NOTIFYII/notifyi-digital-twin/assets/research/capstone_poster.jpg

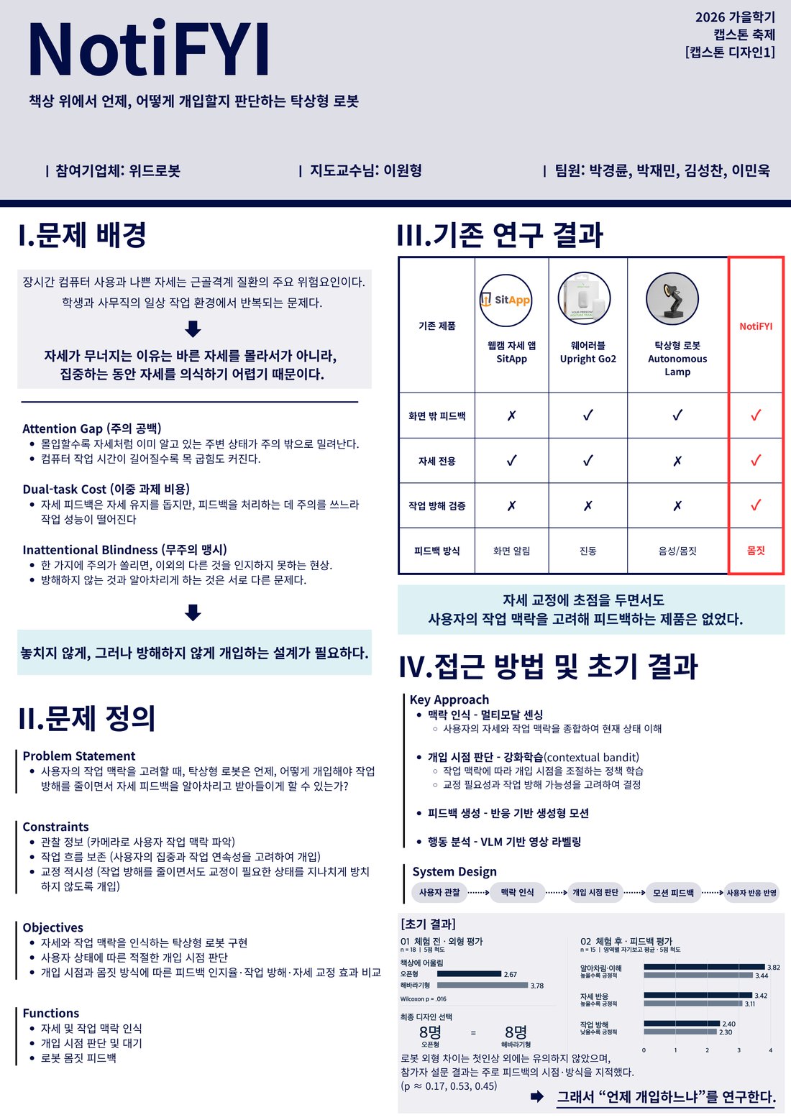
assets/research/capstone_poster.jpg
