NOTIFYII/notifyi-digital-twin/assets/research/botanical_device.jpg

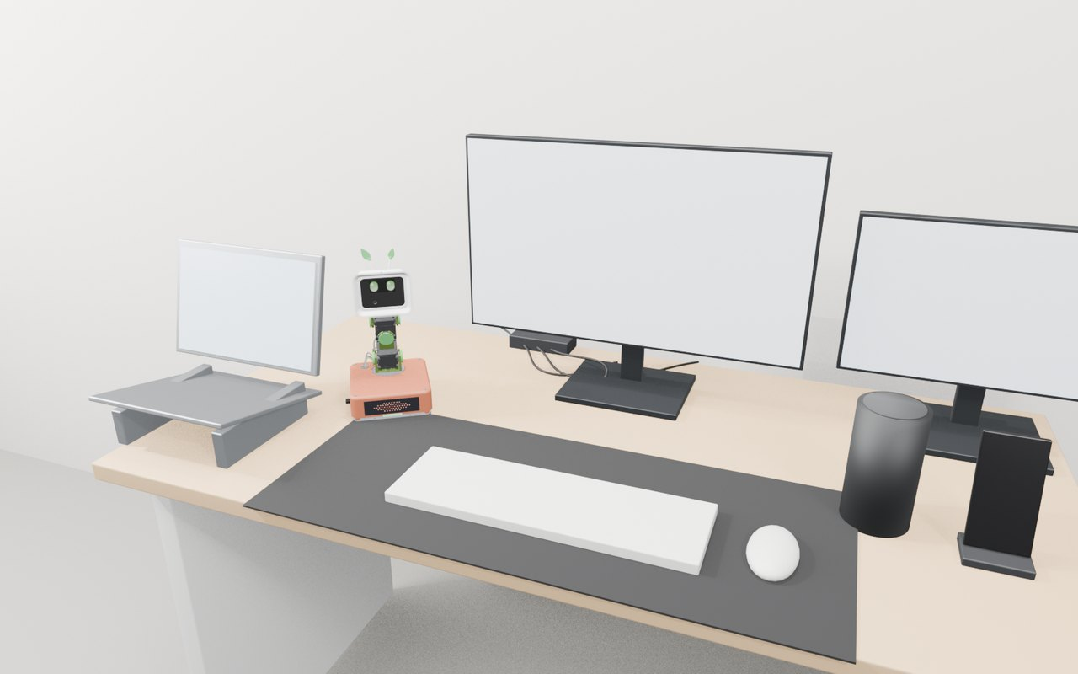
assets/research/botanical_device.jpg
