NOTIFYII/notifyi-digital-twin/assets/research/botanical_plant.jpg

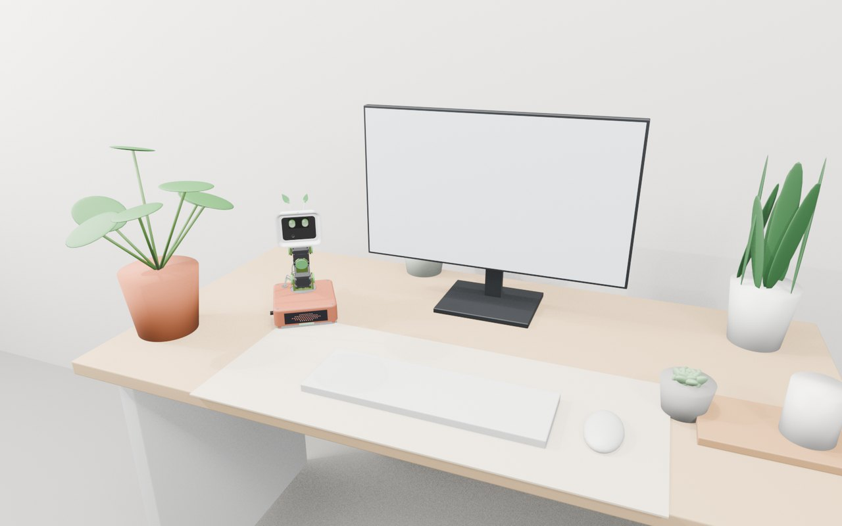
assets/research/botanical_plant.jpg
