NOTIFYII/notifyi-digital-twin/assets/research/hero/t01.jpg

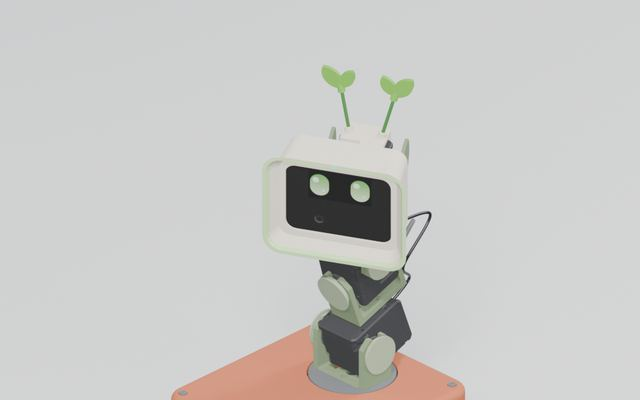
assets/research/hero/t01.jpg
