NOTIFYII/notifyi-digital-twin/assets/research/hero/t03.jpg

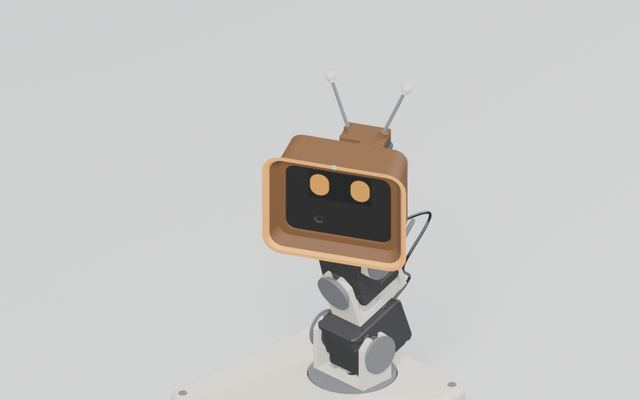
assets/research/hero/t03.jpg
