NOTIFYII/notifyi-digital-twin/assets/research/hero/t04.jpg

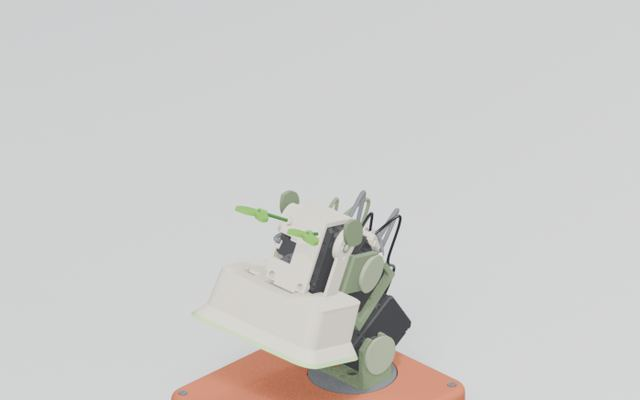
assets/research/hero/t04.jpg
