NOTIFYII/notifyi-digital-twin/assets/research/hero/t05.jpg

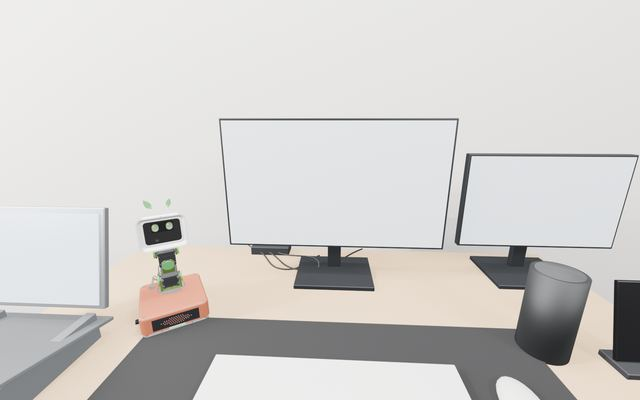
assets/research/hero/t05.jpg
