NOTIFYII/notifyi-digital-twin/assets/research/hero/t06.jpg

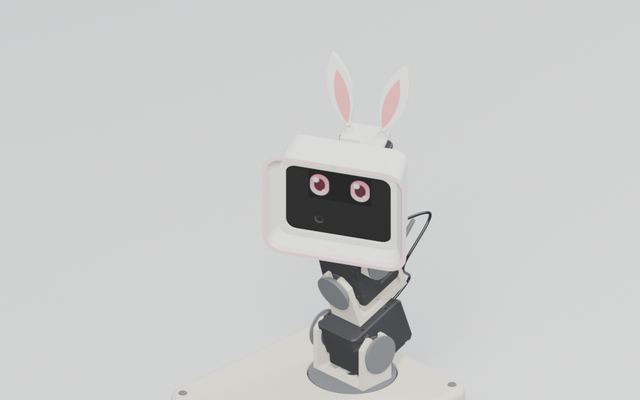
assets/research/hero/t06.jpg
