NOTIFYII/notifyi-digital-twin/assets/research/hero/t07.jpg

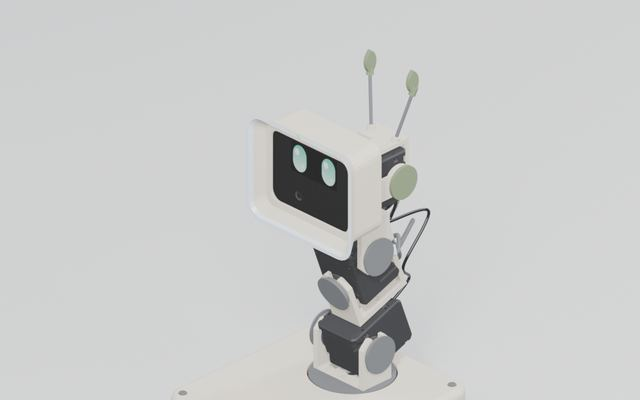
assets/research/hero/t07.jpg
