NOTIFYII/notifyi-digital-twin/assets/research/hero/t09.jpg

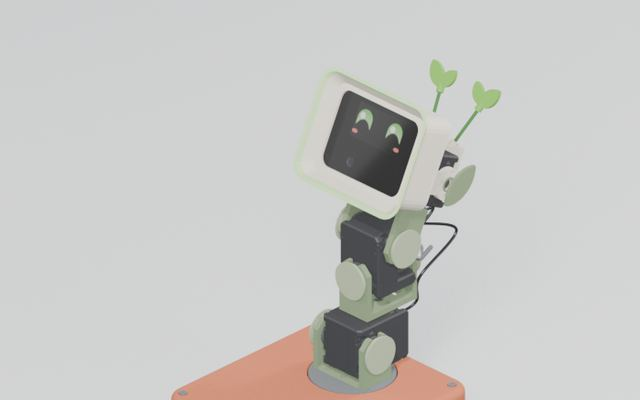
assets/research/hero/t09.jpg
