NOTIFYII/notifyi-digital-twin/assets/research/power_curves_mixed.png

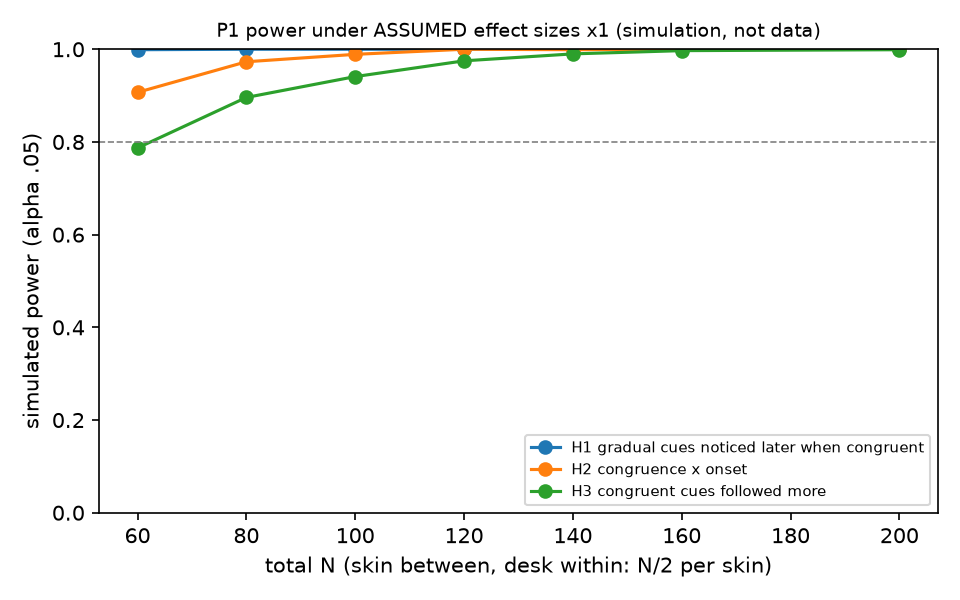
assets/research/power_curves_mixed.png
