NOTIFYII/notifyi-digital-twin/assets/research/power_curves_scale0.5_mixed.png

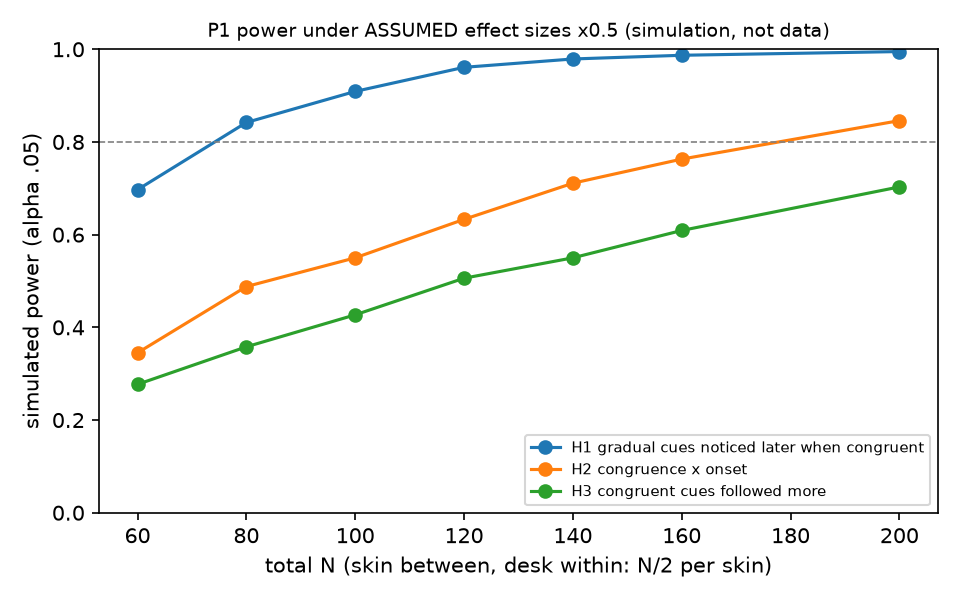
assets/research/power_curves_scale0.5_mixed.png
