NOTIFYII/notifyi-digital-twin/assets/mech_M11d_wired/print/cubicon_plates/P10_shell_rear_pieces/base_shell_rear.stl

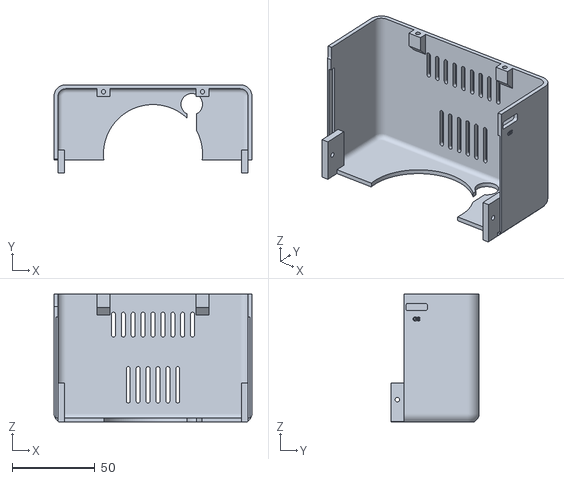
[picture p13: CAD file, 2026-11-02]
assets/mech_M11d_wired/print/cubicon_plates/P10_shell_rear_pieces/base_shell_rear.stl
120.0 x 53.6 x 77.5
