NOTIFYII/notifyi-digital-twin/assets/mech_M11d_wired/print/cubicon_plates/P1_shell_front_pieces/base_shell_front.stl

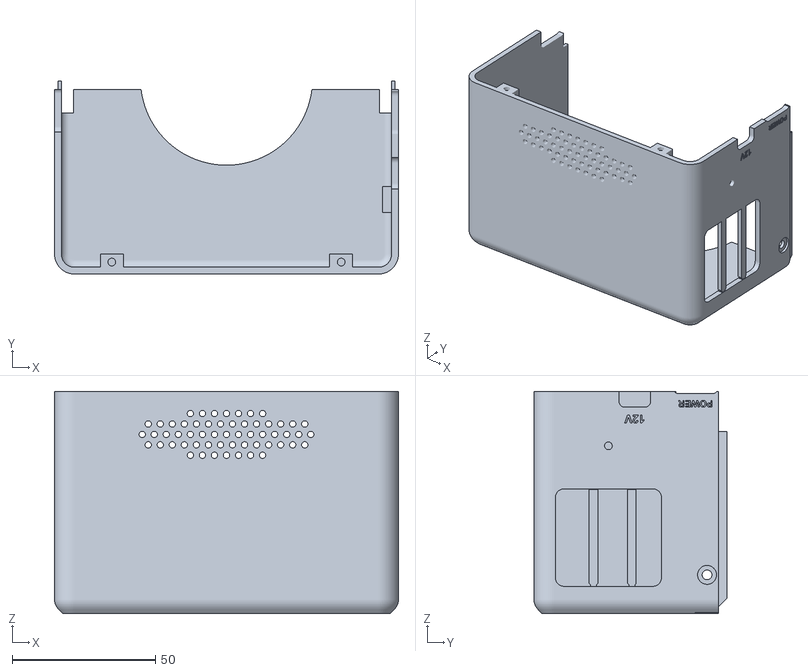
[picture p14: CAD file, 2026-11-02]
assets/mech_M11d_wired/print/cubicon_plates/P1_shell_front_pieces/base_shell_front.stl
120.0 x 67.4 x 77.5
