NOTIFYII/notifyi-digital-twin/assets/mech_M11d_wired/print/cubicon_plates/P2_base_floor_pieces/base_floor.stl

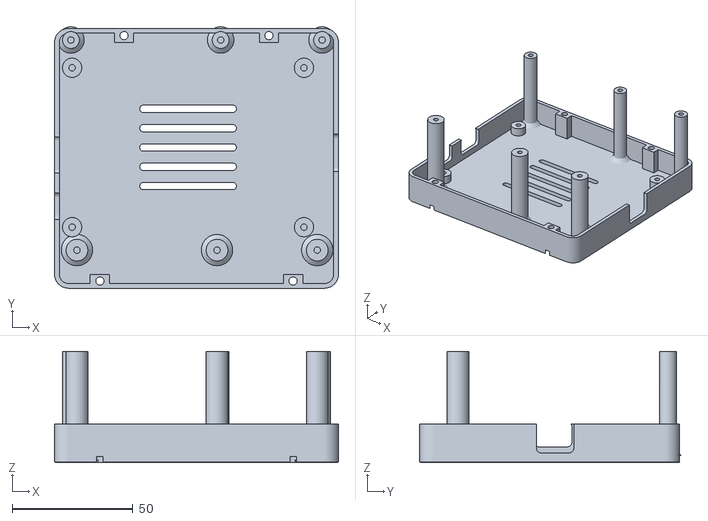
[picture p15: CAD file, 2026-11-02]
assets/mech_M11d_wired/print/cubicon_plates/P2_base_floor_pieces/base_floor.stl
117.6 x 108.3 x 46.0
