NOTIFYII/notifyi-digital-twin/assets/mech_M11d_wired/print/cubicon_plates/P3_servo_deck_pieces/servo_deck.stl

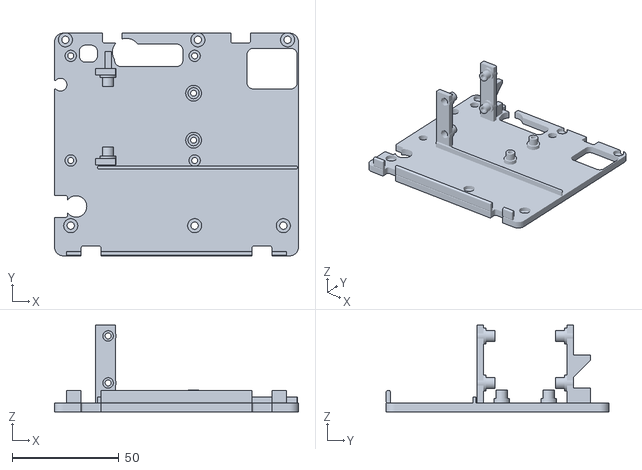
[picture p16: CAD file, 2026-11-02]
assets/mech_M11d_wired/print/cubicon_plates/P3_servo_deck_pieces/servo_deck.stl
114.2 x 104.2 x 40.5
