NOTIFYII/notifyi-digital-twin/assets/mech_M11d_wired/print/cubicon_plates/P4_head_face_pieces/head_face.stl

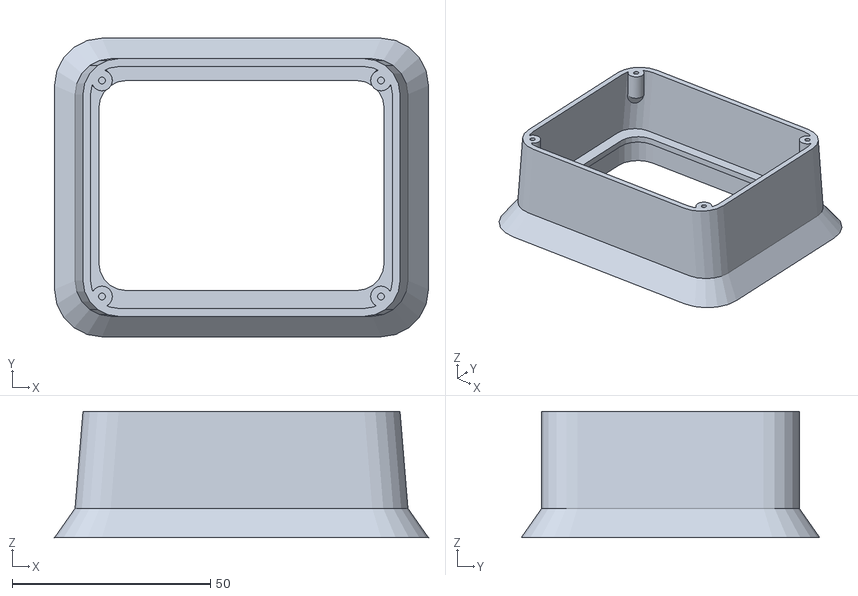
[picture p17: CAD file, 2026-11-02]
assets/mech_M11d_wired/print/cubicon_plates/P4_head_face_pieces/head_face.stl
94.4 x 75.4 x 31.9
