NOTIFYII/notifyi-digital-twin/assets/mech_M11d_wired/print/cubicon_plates/P5_camera_cradle_pieces/camera_cradle.stl

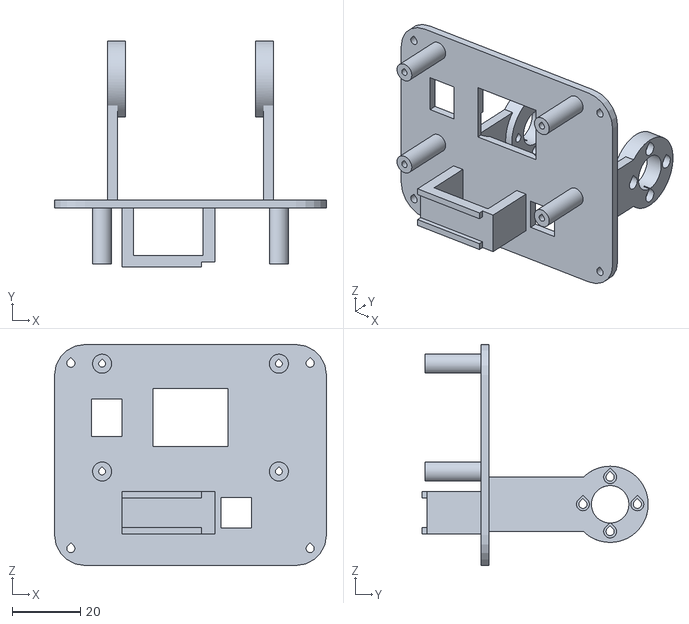
[picture p18: CAD file, 2026-11-02]
assets/mech_M11d_wired/print/cubicon_plates/P5_camera_cradle_pieces/camera_cradle.stl
80.0 x 66.6 x 65.0
