NOTIFYII/notifyi-digital-twin/assets/mech_M11d_wired/print/cubicon_plates/P6_yokes_pieces/yoke_3.stl

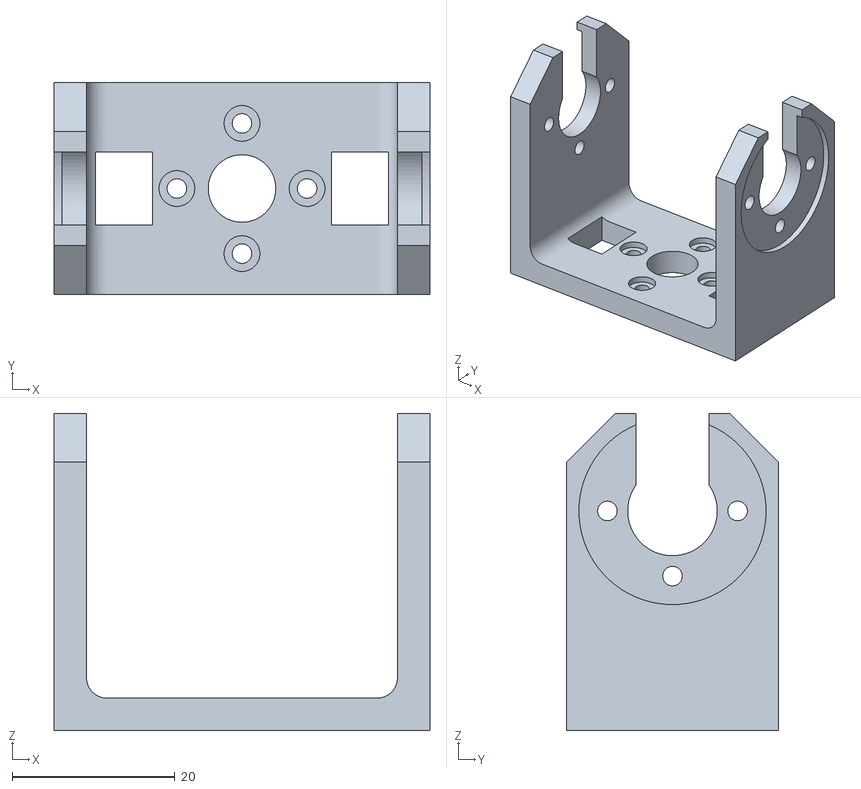
[picture p19: CAD file, 2026-10-30]
assets/mech_M11d_wired/print/cubicon_plates/P6_yokes_pieces/yoke_3.stl
46.2 x 26.0 x 39.0
