NOTIFYII/notifyi-digital-twin/assets/mech_M11d_wired/print/cubicon_plates/P7_sled_strap.3mf

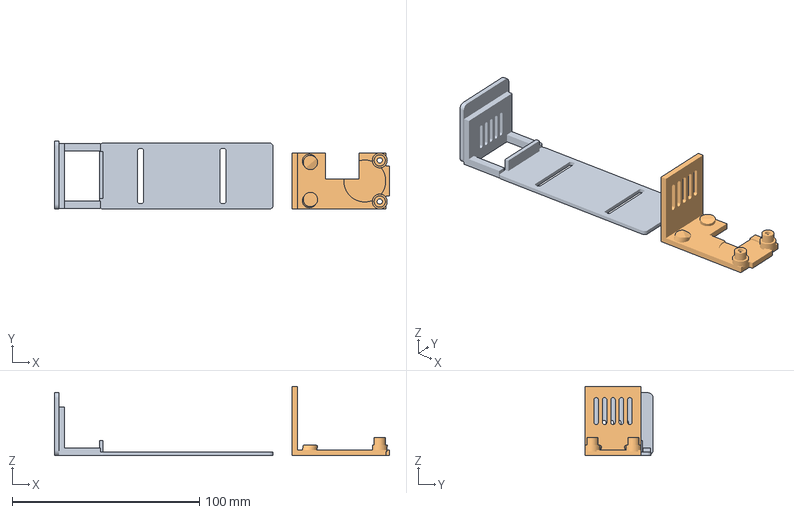
[picture p20: CAD file, 2026-11-02]
assets/mech_M11d_wired/print/cubicon_plates/P7_sled_strap.3mf
178.9 x 36.4 x 37.0 mm
battery_sled
head_strap
