NOTIFYII/notifyi-digital-twin/assets/mech_M11d_wired/print/cubicon_plates/P7_sled_strap_pieces/head_strap.stl

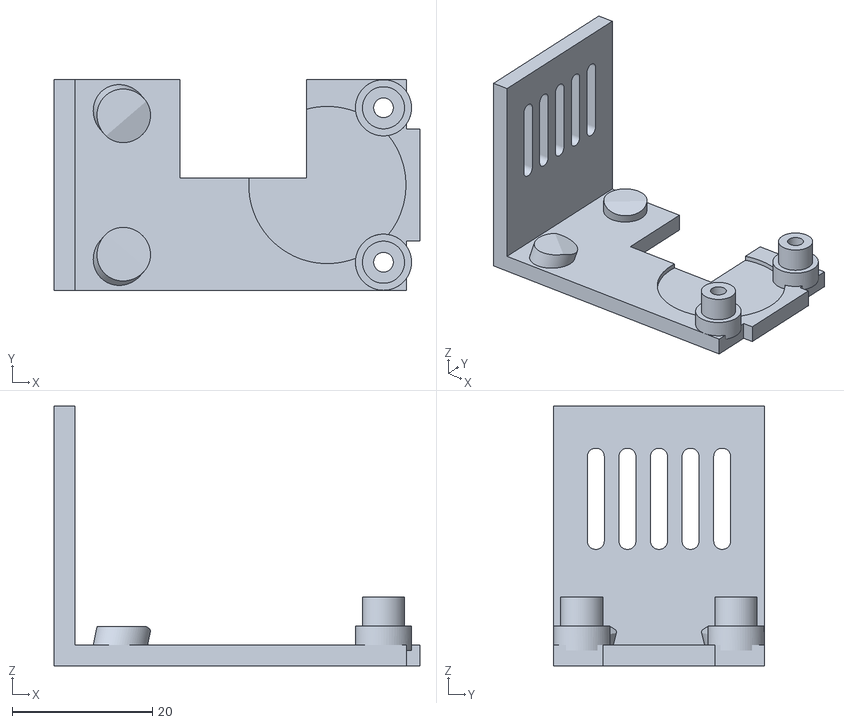
[picture p21: CAD file, 2026-11-02]
assets/mech_M11d_wired/print/cubicon_plates/P7_sled_strap_pieces/head_strap.stl
52.1 x 30.0 x 37.0
