NOTIFYII/notifyi-digital-twin/assets/mech_M11d_wired/print/cubicon_plates/P8_flat_parts_pieces/shoulder_plate.stl

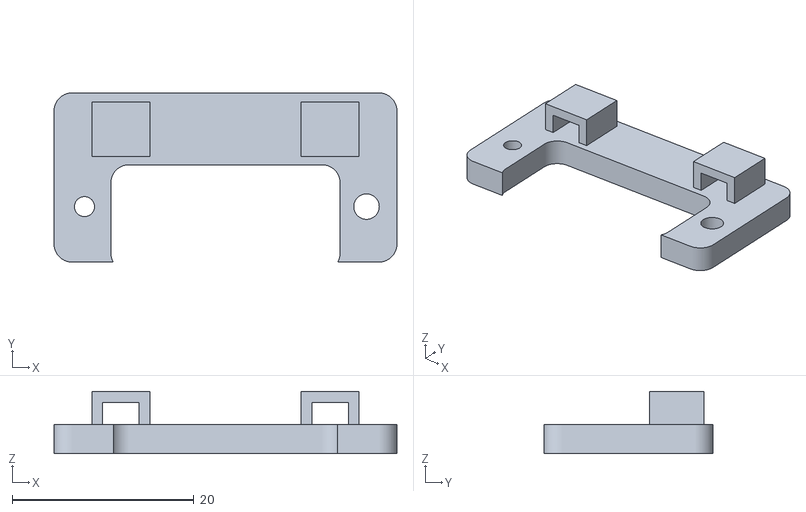
[picture p22: CAD file, 2026-11-02]
assets/mech_M11d_wired/print/cubicon_plates/P8_flat_parts_pieces/shoulder_plate.stl
37.7 x 18.6 x 6.85
