NOTIFYII/notifyi-digital-twin/assets/mech_M11d_wired/print/cubicon_plates/P9_small_parts_pieces/antenna_rod_2.stl

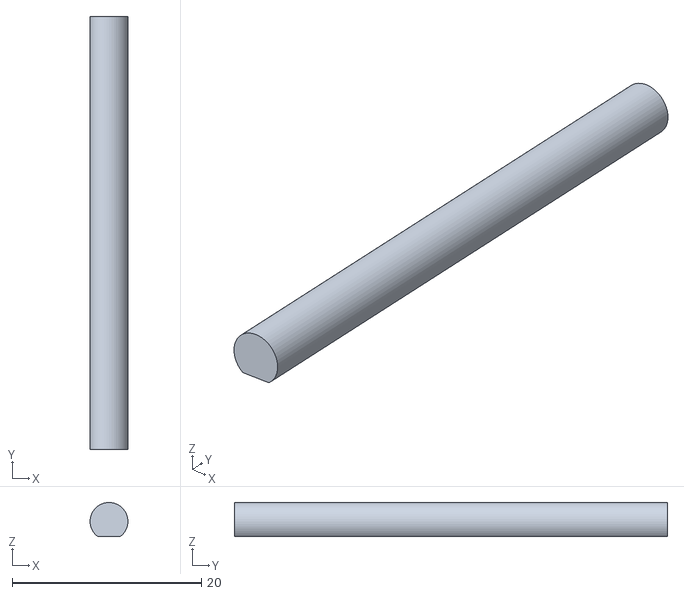
[picture p23: CAD file, 2026-10-30]
assets/mech_M11d_wired/print/cubicon_plates/P9_small_parts_pieces/antenna_rod_2.stl
4.00 x 45.8 x 3.60
