NOTIFYII/notifyi-digital-twin/assets/mech_M11d_wired/print/cubicon_plates/P7_sled_strap_pieces/battery_sled.stl

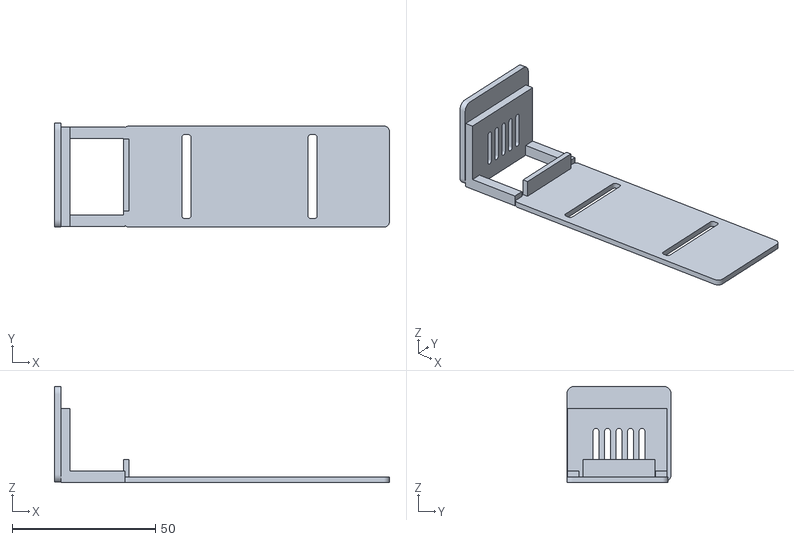
[picture p24: CAD file, 2026-10-29]
assets/mech_M11d_wired/print/cubicon_plates/P7_sled_strap_pieces/battery_sled.stl
116.8 x 36.4 x 33.6
