NOTIFYII/notifyi-digital-twin/assets/mech_M11d_wired/print/cubicon_plates/P8_flat_parts_pieces/base_front_panel.stl

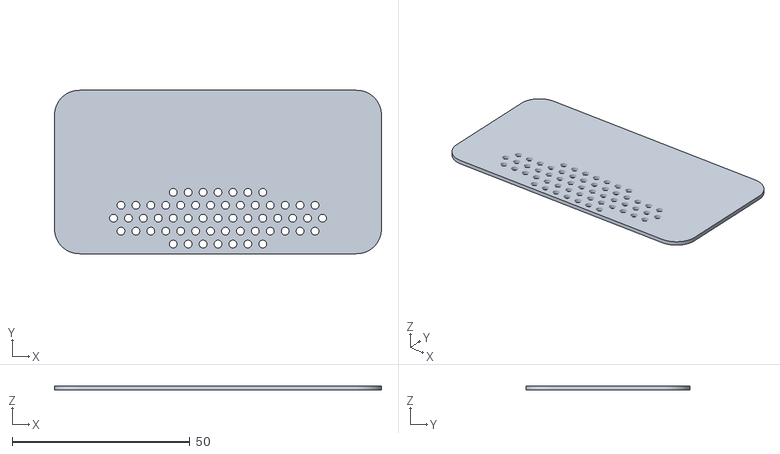
[picture p25: CAD file, 2026-10-30]
assets/mech_M11d_wired/print/cubicon_plates/P8_flat_parts_pieces/base_front_panel.stl
92.0 x 46.0 x 1.20
