NOTIFYII/notifyi-digital-twin/assets/mech_M11d_wired/print/cubicon_plates/P9_small_parts_pieces/antenna_tips_L.stl

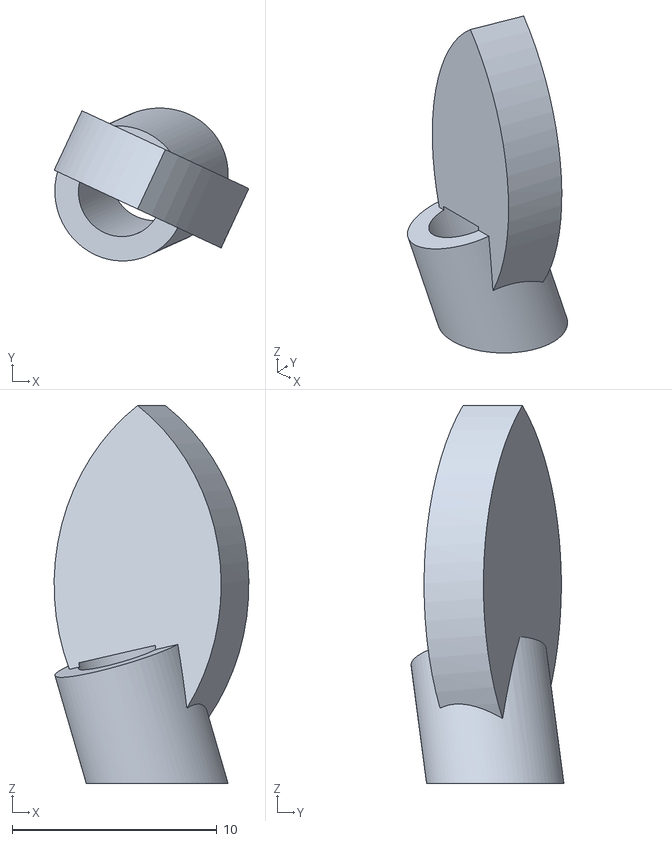
[picture p26: CAD file, 2026-10-30]
assets/mech_M11d_wired/print/cubicon_plates/P9_small_parts_pieces/antenna_tips_L.stl
9.50 x 7.46 x 18.5
