NOTIFYII/notifyi-digital-twin/assets/mech_M11d_wired/print/cubicon_plates/P6_yokes.3mf

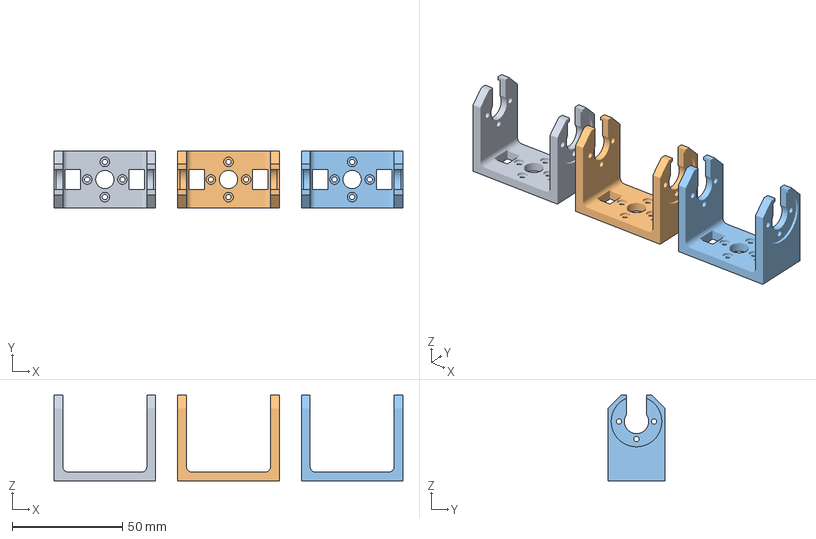
[picture p27: CAD file, 2026-11-02]
assets/mech_M11d_wired/print/cubicon_plates/P6_yokes.3mf
158.6 x 26.0 x 39.0 mm
yoke_1
yoke_2
yoke_3
