NOTIFYII/notifyi-digital-twin/assets/mech_M11d_wired/print/cubicon_plates/P8_flat_parts_pieces/head_ring.stl

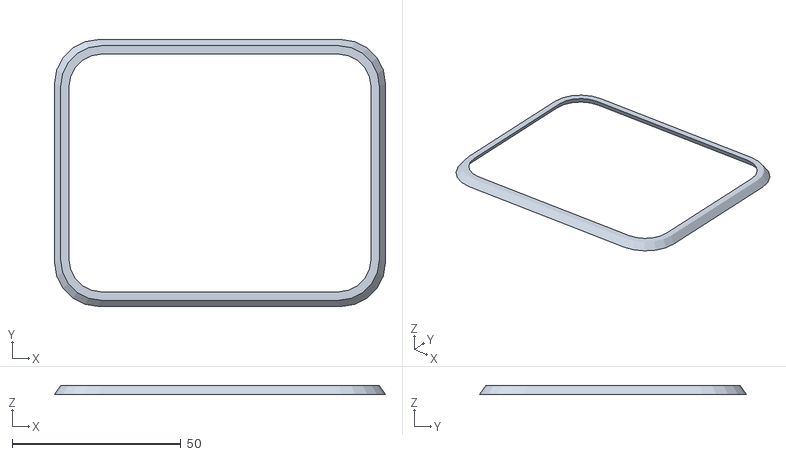
[picture p28: CAD file, 2026-10-30]
assets/mech_M11d_wired/print/cubicon_plates/P8_flat_parts_pieces/head_ring.stl
98.0 x 79.0 x 2.60
