NOTIFYII/notifyi-digital-twin/assets/mech_M11d_wired/print/cubicon_plates/P9_small_parts_pieces/pivot_cap_1p0_frame_dark_5.stl

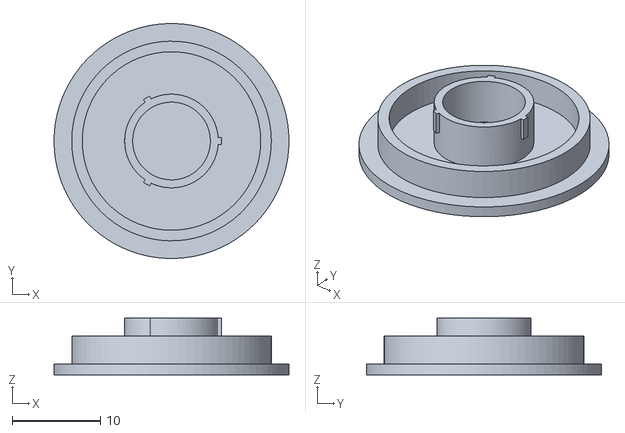
[picture p29: CAD file, 2026-10-30]
assets/mech_M11d_wired/print/cubicon_plates/P9_small_parts_pieces/pivot_cap_1p0_frame_dark_5.stl
26.6 x 26.6 x 6.40
