NOTIFYII/notifyi-digital-twin/assets/mech_M11d_wired/print/cubicon_plates/P8_flat_parts_pieces/head_ears_R.stl

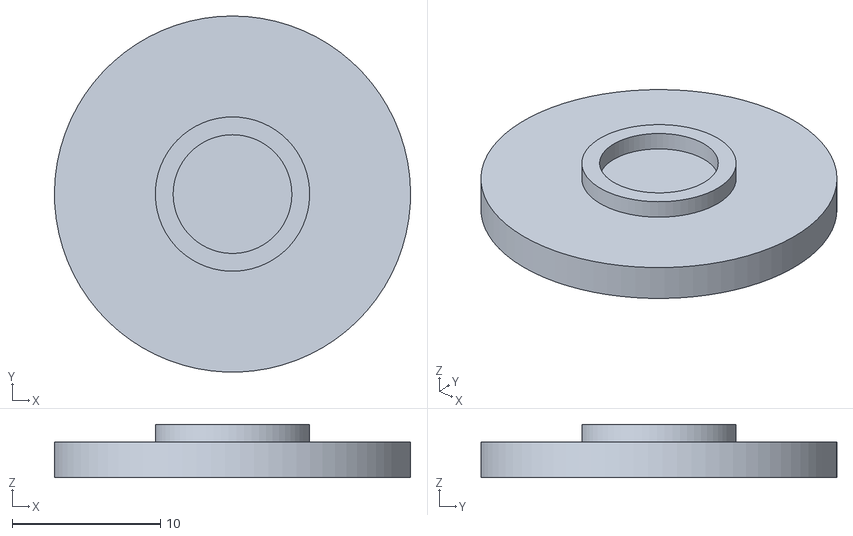
[picture p30: CAD file, 2026-10-30]
assets/mech_M11d_wired/print/cubicon_plates/P8_flat_parts_pieces/head_ears_R.stl
24.0 x 24.0 x 3.60
