NOTIFYII/notifyi-digital-twin/assets/mech_M11d_wired/print/cubicon_plates/P8_flat_parts.3mf

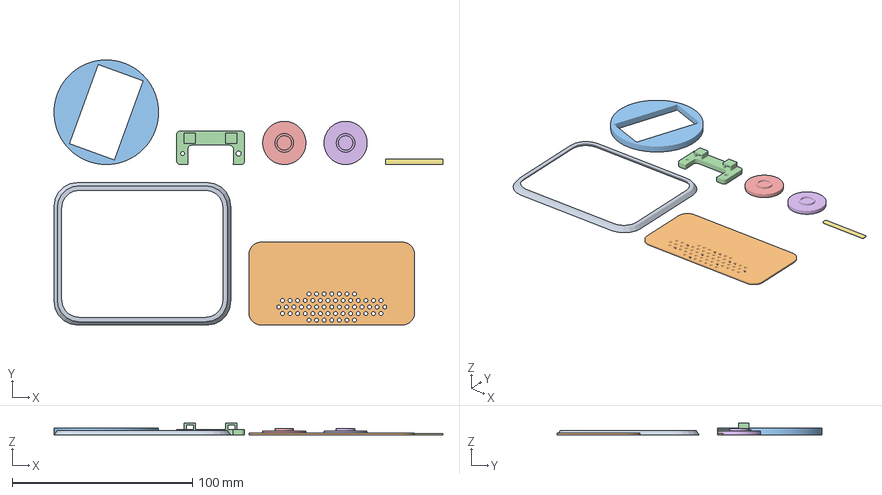
[picture p31: CAD file, 2026-11-02]
assets/mech_M11d_wired/print/cubicon_plates/P8_flat_parts.3mf
215.7 x 147.0 x 6.85 mm
head_ring
base_front_panel
turntable_ring
shoulder_plate
head_ears_L
head_ears_R
led_band
