NOTIFYII/notifyi-digital-twin/assets/mech_M11d_wired/print/cubicon_plates/P8_flat_parts_pieces/led_band.stl

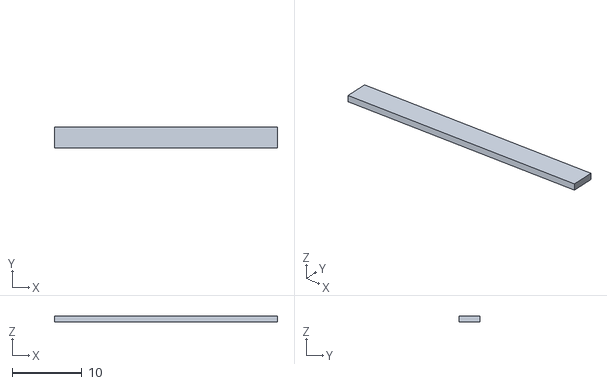
[picture p32: CAD file, 2026-10-30]
assets/mech_M11d_wired/print/cubicon_plates/P8_flat_parts_pieces/led_band.stl
32.0 x 3.00 x 0.8
