NOTIFYII/notifyi-digital-twin/assets/mech_M11d_wired/print/cubicon_plates/P8_flat_parts_pieces/turntable_ring.stl

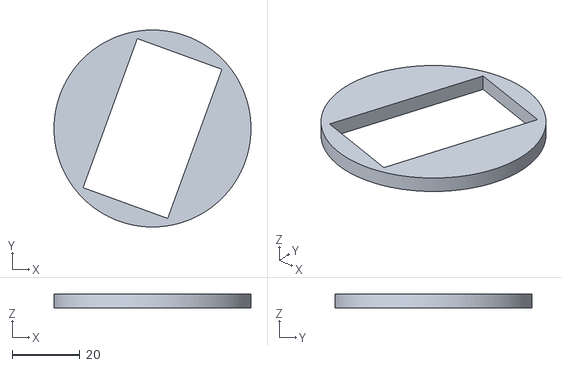
[picture p33: CAD file, 2026-10-30]
assets/mech_M11d_wired/print/cubicon_plates/P8_flat_parts_pieces/turntable_ring.stl
58.0 x 58.0 x 4.00
