NOTIFYII/notifyi-digital-twin/assets/mech_M11d_wired/print/cubicon_plates/P9_small_parts.3mf

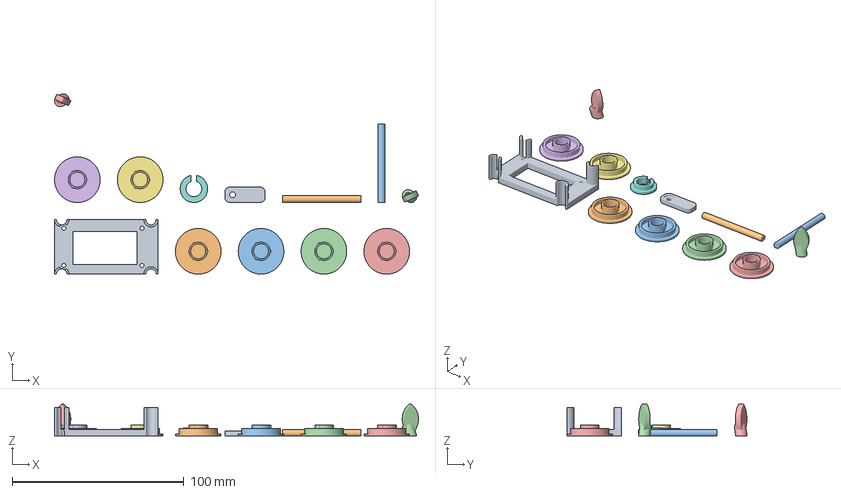
[picture p34: CAD file, 2026-11-02]
assets/mech_M11d_wired/print/cubicon_plates/P9_small_parts.3mf
212.0 x 105.0 x 18.5 mm
display_frame
pivot_cap_1p0_frame_dark_1
pivot_cap_1p0_frame_dark_2
pivot_cap_1p0_frame_dark_3
pivot_cap_1p0_frame_dark_4
pivot_cap_1p0_frame_dark_5
pivot_cap_1p0_frame_dark_6
cable_bushing
door_latch
antenna_rod_1
antenna_rod_2
antenna_tips_R
antenna_tips_L
