NOTIFYII/notifyi-digital-twin/assets/mech_M11d_wired/print/cubicon_plates/P9_small_parts_pieces/door_latch.stl

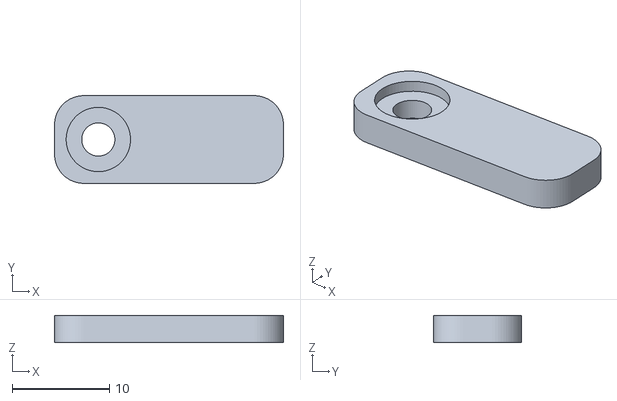
[picture p35: CAD file, 2026-10-30]
assets/mech_M11d_wired/print/cubicon_plates/P9_small_parts_pieces/door_latch.stl
23.5 x 9.00 x 2.80
