NOTIFYII/notifyi-digital-twin/assets/mech_M11d_wired/print/stl/22_display_frame.stl

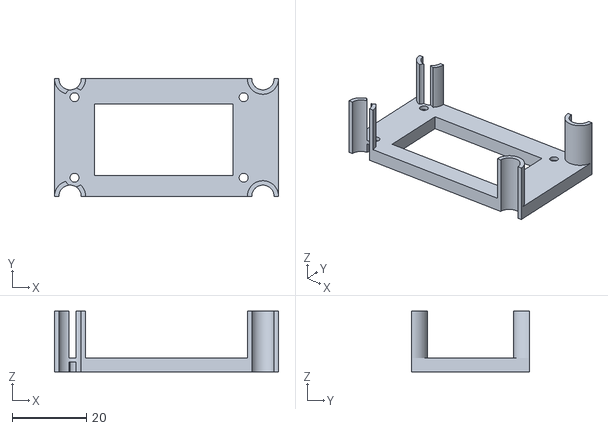
[picture p36: CAD file, 2026-10-30]
assets/mech_M11d_wired/print/stl/22_display_frame.stl
60.4 x 31.7 x 16.4
