NOTIFYII/notifyi-digital-twin/assets/mech_M11d_wired/print/cubicon_plates/P9_small_parts_pieces/cable_bushing.stl

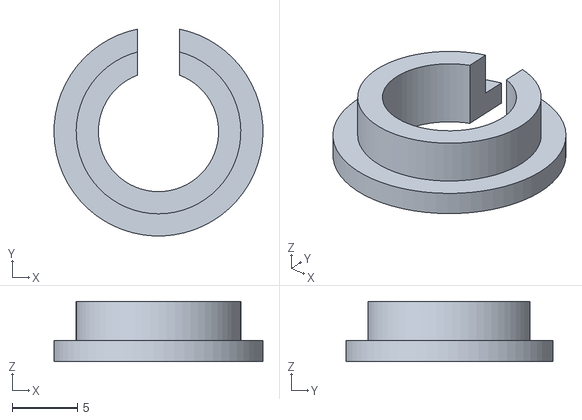
[picture p37: CAD file, 2026-10-30]
assets/mech_M11d_wired/print/cubicon_plates/P9_small_parts_pieces/cable_bushing.stl
16.0 x 15.8 x 4.60
