NOTIFYII/notifyi-digital-twin/(list of files, cad)

Other CAD files:
assets/mech_M11d_wired/print/stl/03_servo_deck.stl
assets/mech_M11d_wired/print/cubicon_plates/P4_head_face.3mf
assets/mech_M11d_wired/print/cubicon_plates/P6_yokes_pieces/yoke_2.stl
assets/mech_M11d_wired/print/stl/15_head_strap.stl
assets/mech_M11d_wired/print/cubicon_plates/P6_yokes_pieces/yoke_1.stl
assets/mech_M11d_wired/print/stl/14_camera_cradle.stl
assets/mech_M11d_wired/print/cubicon_plates/P1_shell_front.3mf
assets/mech_M11d_wired/print/cubicon_plates/P9_small_parts_pieces/pivot_cap_1p0_frame_dark_1.stl
assets/mech_M11d_wired/print/stl/01_base_shell_rear.stl
assets/mech_M11d_wired/print/cubicon_plates/P8_flat_parts_pieces/head_ears_L.stl
assets/mech_M11d_wired/print/cubicon_plates/P9_small_parts_pieces/pivot_cap_1p0_frame_dark_4.stl
assets/mech_M11d_wired/print/stl/02_base_floor.stl
assets/mech_M11d_wired/print/cubicon_plates/P10_shell_rear.3mf
assets/mech_M11d_wired/print/cubicon_plates/P9_small_parts_pieces/pivot_cap_1p0_frame_dark_6.stl
assets/mech_M11d_wired/print/stl/01_base_shell_front.stl
assets/mech_M11d_wired/print/cubicon_plates/P9_small_parts_pieces/antenna_rod_1.stl
assets/mech_M11d_wired/print/stl/11_shoulder_plate.stl
assets/mech_M11d_wired/print/cubicon_plates/P2_base_floor.3mf
assets/mech_M11d_wired/print/stl/12_head_face.stl
assets/mech_M11d_wired/print/cubicon_plates/P5_camera_cradle.3mf
assets/mech_M11d_wired/print/cubicon_plates/P9_small_parts_pieces/antenna_tips_R.stl
assets/mech_M11d_wired/print/cubicon_plates/P3_servo_deck.3mf
assets/mech_M11d_wired/print/cubicon_plates/P9_small_parts_pieces/pivot_cap_1p0_frame_dark_3.stl
assets/mech_M11d_wired/print/stl/05_door_latch.stl
assets/mech_M11d_wired/print/cubicon_plates/P9_small_parts_pieces/display_frame.stl
assets/mech_M11d_wired/print/stl/20_led_band.stl
assets/mech_M11d_wired/print/cubicon_plates/P9_small_parts_pieces/pivot_cap_1p0_frame_dark_2.stl
assets/mech_M11d_wired/print/stl/04_battery_sled.stl
assets/mech_M11d_wired/print/stl/07_cable_bushing.stl
assets/mech_M11d_wired/print/stl/06_base_front_panel.stl
assets/mech_M11d_wired/print/stl/09_yoke.stl
assets/mech_M11d_wired/print/stl/19_head_ears_R.stl
assets/mech_M11d_wired/print/stl/21_antenna_rod.stl
assets/mech_M11d_wired/print/stl/16_antenna_tips_L.stl
assets/mech_M11d_wired/print/stl/17_antenna_tips_R.stl
assets/mech_M11d_wired/print/stl/18_head_ears_L.stl
assets/mech_M11d_wired/print/stl/10_pivot_cap_1p0_frame_dark.stl
assets/mech_M11d_wired/print/stl/08_turntable_ring.stl
assets/mech_M11d_wired/print/stl/13_head_ring.stl
assets/mech_M11d_wired/print/cubicon_plates/P6_yokes.stl
assets/mech_M11d_wired/print/cubicon_plates/P7_sled_strap.stl
assets/mech_M11d_wired/print/cubicon_plates/P8_flat_parts.stl
assets/mech_M11d_wired/print/cubicon_plates/P9_small_parts.stl
