NOTIFYII/notifyi-digital-twin/print.html

Notifyi

# M11c · Cubicon 출력 (.hfb)

학교 Cubicon Single Plus(베드 240 × 190 × 200 mm)는 Cubicreator로 슬라이스한 .hfb만 출력합니다. 아래 10판의 .hfb는 Cubicreator4(장비 3DP-310F · PLA)로 저장한 파일입니다 — USB 메모리(FAT32)에 넣고 프린터에서 고르면 바로 출력됩니다(영문 파일명만 보임). 흰 PLA로 뽑은 뒤 RC3 색으로 칠합니다. 판을 누르면 그 판이 베드 위에 놓인 그대로 보입니다(색 = 칠할 색).

불러오는 중…

## –

.hfb 받기 이 판 STL 입체위옆

### 이 판에 들어간 조각

M11d (2026-11-02): 출력 부품은 M11c와 같습니다. 바뀐 것은 설명서와 3D의 나사 · 케이블, 그리고 구매 나사 규격입니다. 아래 파일은 그대로 쓰세요.

M11c (2026-11-02): 외피를 맨 마지막에 씌웁니다 — 외피가 앞뒤 두 쪽(P1 · P10)으로 나뉘어, 로봇을 다 조립하고 배선을 정리한 뒤 닫고, 나사 6개만 풀면 다시 열립니다. 나사 72개를 실제 구멍과 하나씩 대조해 고쳤습니다: M3 Ø 2.7 · M2 Ø 1.7(인서트 없음), 작은 가로 구멍 안에 지지대 없음, 0.3 mm 막 없음, 어깨판 나사를 P3의 실제 구멍으로. 이미 출력했다면 꼭 새로 뽑을 것은 외피 두 쪽과 어깨판입니다(부품별 STL). 다른 부품의 재사용 방법은 조립 설명서 첫 단계에 있습니다.

부품별 STL (다른 슬라이서 · 수정용)

전체 STL (zip) 판 표 JSON

지지대 · 보조물 떼기

- 베이스 외피 앞쪽: 문 위 받침 웹 2개 — 펜치로 가운데를 잡고 옆으로 꺾으면 아래쪽 목에서 부러집니다(약 2 N). 남은 돌기는 줄로. 문에 가려지는 면입니다.
- 바닥 트레이: 지지대 · 막 없음. 나사 머리 자리의 천장이 두 단계 브리지로 뽑혀 나사 구멍이 처음부터 뚫려 있습니다.
- 얼굴 상자: 후드 안에 서 있는 링 — 부품과 붙어 있지 않으니(0.25 mm 띄움) 들어내면 끝.
- 머리 윗판: 지지대 · 막 없음(바닥 트레이와 같은 방식).
- 카메라 받침 (유일한 지지대): P5 .hfb에 지지대가 켜져 있습니다. 작은 가로 나사 구멍은 위쪽을 45°로 뾰족하게 만들어 그 안에는 지지대가 생기지 않도록 했습니다(첫 출력에서 확인해 주세요). Ø 11 허브 안과 팔 아래의 지지대는 니퍼로 잘라 내고, 기둥이나 팔을 지렛대로 쓰지 마세요.
- 서보 데크: P1 옆 홈에 들어가는 짧은 핀 4개(4 mm)는 지지대 없이 뽑힙니다. 아래쪽이 0.3 mm쯤 처져도 홈 여유가 0.7 mm라 괜찮고, 거칠면 줄로 살짝.
- 디스플레이 프레임 (새 부품): 지지대 · 보조물 없음. 앞면(모듈이 닿는 면)을 베드에 — 스터드 구멍 4개 위 1.1 mm 바닥은 짧은 브리지라 그대로 나옵니다. 반원 홈 안쪽이 거칠면 받침 기둥에 끼우기 전에 줄로 살짝.

물리 검토 — 떼는 힘 · 층 방향 · 나사 길이

- 가정: PLA 강도 층 방향 40 MPa, 층 사이(접착) 15 MPa — 오래된 프린터를 생각해 공개 값의 낮은 쪽. 펜치로 지지대를 뗄 때 보통 20 N, 세게 40 N. 보 공식(σ = M / W) 손계산이라 위험 순위를 정하는 용도이고, 실물 검증은 아닙니다.
- 지지대를 떼도 부품이 견디는가: 가장 약한 곳은 카메라 받침의 디스플레이 기둥(Ø 5.6, 16 mm) — 40 N에 안전율 2.1(그래서 니퍼로 자르라는 안내). 팔은 7.2, 카메라 포켓 바닥 12.7.
- 보조물이 부품보다 먼저 부러지는가: 문 위 웹의 목은 외피 벽보다 32배 약하고, 바닥 웹의 목은 받침보다 19배 약합니다 — 부러지면 목에서 부러집니다.
- 층 방향이 바뀐 부품: 요크를 바닥판이 아래로 세워 뽑으면 층이 다리를 가로지르지만, 관절 토크로 다리에 걸리는 응력은 0.4 MPa(서보가 막혀 1.4 N·m를 낼 때 3.1 MPa)라 안전율 4.8 이상. 머리 윗판 나사 기둥 9.3, 안테나 소켓은 막대(Ø 4)가 먼저 부러져 윗판을 보호합니다.
- M9에서 찾은 실제 오류도 고쳤습니다: 서보 데크의 P1 나사 보스 벽 0.15 mm, Pi 레일 받침 인서트가 받침 끝을 뚫고 아래로 1.2 mm 나옴, 레일 나사 머리 홈 벽 0.05 mm, 귀 · 어깨판 출력 방향이 뒤집혀 있었음, 안테나 막대 출력 파일이 8 mm 짧았음, 외피 고정 나사 M3 × 12는 인서트에 닿지 않음(→ M3 × 18), 레일 나사 M2.5 × 8은 OpenCR 헤더까지 내려감(→ × 5).

PLA로 다시 설계한 원칙

- 지지대는 형상으로 없앰 — 오버행 45° 이내(보강 · 코벨 · 모따기), 긴 가로 슬롯 대신 세로 슬롯, 브리지 25 mm 이하. 꼭 필요하면 부품보다 약한 목을 가진 보조물로.
- 휘는 부품 없음 — 스냅핏 · 걸쇠 · TPU 부품을 나사 · 돌리는 버튼 · 단단한 부싱으로 바꿈 (PLA는 휘면 부러짐).
- 나사 구멍은 나사 규격대로 — 나사가 물리는 구멍: M3 Ø 2.7, M2 Ø 1.7(인서트 없음, 나사가 직접 나사산을 냄). 나사가 지나가는 구멍: M2 Ø 2.4, M2.5 Ø 2.8, M3 Ø 3.4(머리 받침 포함). 머리가 닿으면 멈추세요 — 세게 조이면 PLA 나사산이 뭉개집니다.
- 압입은 크러시 리브로 — 0.15 mm 리브가 깎이며 들어가 링이 쪼개지지 않음 (피벗 캡).
- 층 방향 — 하중이 큰 곳은 층을 따라가게(안테나 막대는 눕혀서, 카메라 받침 팔은 층 방향), 층을 가로지르는 곳은 응력을 계산해 확인(요크 다리).
- 열 — PLA는 55–60 °C에서 물러짐. 서보 · Pi 주변은 큰 힘을 받지 않게 했고 통풍구를 둠. 차 안 · 직사광선 보관 금지. 30분 연속 동작 후 온도 확인은 아직 안 함.

칠하기 (흰 PLA → RC3 색)

- 색: 크림 — 베이스 외피 · 배터리 문 · 얼굴 상자 · 머리 윗판 · 카메라 받침 · 요크 · 어깨판 / 다크 그레이 — 바닥 트레이 · 서보 데크 · Pi 레일 · 피벗 캡 · 안테나 막대 · 문 버튼 / 올리브 — 안테나 잎 · 귀 · 턴테이블 링 · 케이블 부싱 / 검정 — 앞 패널.
- 칠하지 않음: 얼굴 테 · 라이트 띠 · 디스플레이 프레임(디스플레이 뒤라 보이지 않음) — 흰 PLA가 빛을 퍼뜨립니다(밝기는 실물에서 확인).
- 순서: 지지대 · 보조물 떼기 → 400방 사포 → 플라스틱용 프라이머 → 아크릴 스프레이를 얇게 2–3번 → 무광 클리어.
- 칠하지 말고 가릴 곳(도막 0.05–0.1 mm만큼 빡빡해짐): 나사 구멍, 요크 허브 구멍과 피벗 캡 축 · 크러시 리브, 배터리 슬레드가 미끄러지는 면과 문 테두리, 안테나 소켓 · 막대 끝, 어깨판이 서보에 닿는 면, 외피와 바닥 트레이가 맞닿는 테두리.
- 안쪽 부품(서보 데크 · Pi 레일)은 보이지 않으니 칠하지 않아도 됩니다. 12V · POWER · SD 각인은 두껍게 칠하면 메워지니, 칠한 뒤 검은 먹선으로 채우면 잘 보입니다.

조립 순서 · 나사

- 순서와 단계별 나사 · 케이블은 조립 설명서 탭(26단계)에 CAD 조립체 그대로 있습니다. 외피 없이 끝까지 조립 · 배선 · 점검한 뒤 외피를 맨 마지막에 닫습니다.
- 디스플레이 프레임 → 모듈: M2 × 3 렌치볼트 4개, 살짝만(황동 스터드에 약 1.7 mm 물림, 나사 머리 밑 바닥 1.1 mm).
- 카메라 케이블은 받침 오른쪽 구멍이 아니라 왼쪽 디스플레이 창으로 뺍니다(오른쪽 구멍 뒤 0.35 mm에 P4가 있음). 케이블 타이는 어깨판 클립 홈으로 통과시켜 묶습니다.

판마다의 예상 시간 · 무게는 Cubicreator4가 슬라이스한 뒤 보여 준 값입니다(10판 합계 약 40.1시간 · 388 g). 부품별 값은 PrusaSlicer 해석값(참고용)입니다. 미리보기 색은 칠한 뒤의 RC3 색입니다. 실물 출력 · 칠 · 조립 · 결선 · 발열은 검증 전입니다.

드래그: 회전 · 휠: 확대 · 우클릭: 이동 · 흰 사각형 = Cubicon 베드 240 × 190 mm

STL을 불러오는 중…

## 기준 부품 · 전원 안내

✕

### M11d (2026-11-02) — 나사와 케이블을 실제 자리에

- 케이블: 모든 케이블이 실제 커넥터에서 시작해 실제 커넥터에서 끝납니다. 카메라 케이블은 보드의 4핀 플러그에서, 디스플레이는 동봉 케이블과 점퍼 8개 두 토막으로 나뉘어 어깨판 뒤 이음부에서 만납니다. 조립 설명서에 OpenCR ↔ Pi USB와 OpenCR → P1 버스가 각각 한 단계씩 생겼습니다. 선 색은 구분용입니다.
- 나사: 81개 전부를 실제 모양으로 그렸고, 설명서 각 단계에서 자기 구멍으로 들어갑니다. '투시' 버튼으로 안쪽을 볼 수 있습니다.
- 구매 규격에 맞춤: 국내에서 바로 살 수 있게 M3 × 18 → M3 × 20, M2.5 × 5 → × 6, M2 × 3 → 십자 둥근머리, 패드 · 어깨판 → 렌치볼트로 바꿨습니다. 배터리는 OpenCR 기본 배터리인 LB-012로 그렸습니다. 출력 부품은 M11c와 같습니다.

### M11c (2026-11-02) — 외피를 맨 마지막에, 나사 구멍 전수 검토

- 외피 두 쪽: 한 덩어리 외피는 머리가 달린 뒤에는 씌울 수 없어서, 배선 전에 씌워야만 했습니다. 이제 앞뒤 두 쪽(P1 · P10)이 완성된 로봇을 양쪽에서 감쌉니다. 뒤쪽 윗면 슬롯으로 케이블을 꽂은 채 끼웁니다. 나사 6개(바닥 4 · 양옆 2)만 풀면 몸통을 건드리지 않고 다시 열립니다. 양쪽을 닫는 경로를 부품 전체에 대해 시뮬레이션했습니다.
- 나사 72개 전수 확인: 구멍마다 축을 따라 머리 자리, 상대 구멍의 지름 · 동심, 물리는 길이, 바닥 닿음, 공구 경로를 ROBOTIS 원본 STEP과 대조했습니다. 남은 문제 0건(CAD 기준, 실물 전).
- 찾아서 고친 것: ① 어깨판 나사가 P3의 구멍 없는 자리를 겨누고 있었음 → 실제 구멍(왼쪽)으로, 오른쪽은 P3 홈에 걸리는 핀으로. ② 목 요크를 P3에 올리면 P4 나사 4개에 손이 닿지 않음 → P4를 책상에서 먼저. ③ Pi를 달면 P1 아래 나사에 손이 닿지 않음 → P1 먼저. ④ 5 V 리드 양끝 커넥터가 Ø 6 구멍을 못 지남 → 가장자리까지 트인 홈. ⑤ 카메라 받침의 작은 구멍에 지지대가 참 → 45° 뾰족한 구멍. ⑥ 0.3 mm 막 제거. ⑦ 데크 → 기둥 렌치볼트 머리가 배터리 슬레드에 닿음 → 둥근머리.
- 이미 뽑았다면: 꼭 새로 뽑을 것은 외피 두 쪽과 어깨판. P3는 Ø 6 구멍에서 왼쪽 가장자리까지 칼로 4 mm 폭을 트면 그대로 쓸 수 있습니다. Ø 4.0 구멍의 예전 P2 · P1은 M3 인서트가 있어야 나사가 물립니다.
- 아직 실물로 맞춰 본 적은 없습니다: 어깨판과 P10을 먼저 뽑아 나사와 틈을 확인하세요. 남은 숙제: 지지대 없는 구멍이 실제로 그렇게 나오는지(P5), 카메라 케이블 실측, 순간접착제 · 압입이 남은 곳(앞 패널, 얼굴 테, 안테나, 피벗 캡).

### M11b (2026-11-02) — P3가 외피에 걸리는 문제, 나사 구멍 규격

- P3 서보 데크: 외피 안쪽 나사 보스 4개가 벽에서 4.6 mm, 문 버튼 보스가 6 mm 튀어나와 있었는데 데크는 벽에서 0.5 mm만 떨어져 있어 서로 지나갈 수 없었습니다. 데크 가장자리에 홈 5개(보스에서 0.6 mm 여유)를 냈습니다. 외피를 내리는 시뮬레이션으로 확인했습니다.
- 나사 구멍: 예전 Ø 4.0 구멍은 인서트 없이는 M3가 그냥 빠지고, 얼굴 상자의 Ø 1.9는 M2에 거의 물리지 않았습니다. 이제 인서트 없이 나사가 직접 물립니다: M3 Ø 2.7(OpenCR 받침 4 · 기둥 6 · 외피 보스 4 · 문 버튼 1), M2 Ø 1.7(얼굴 상자 보스 4). 머리가 닿으면 멈추세요.
- 다시 뽑을 판: P1 외피 · P2 바닥 트레이 · P3 서보 데크 · P4 얼굴 상자. P5–P9는 그대로. 실물 끼워 맞춤은 아직 확인 전이니 P3 먼저 뽑아 보세요.
- 아직 남은 문제: 지지대가 막는 작은 구멍, 조립 순서(배터리 · microSD · 5 V 리드 등)는 하나씩 고치는 중입니다.

### M11 + 납땜 없는 얼굴 (2026-10-30) — 지금 출력 중인 M11 부품 그대로

- 출력한 M11 부품은 그대로: 이 리비전(mech_M11_face)으로 다시 만든 부품을 M11과 비교했더니 모두 같습니다(받침은 파일까지 같음). 새로 뽑을 부품은 디스플레이 프레임 1개(5.9 g, Cubicreator 1시간 17분, 지지대 없음) — 출력 도면 탭 P9 판(.hfb)에 들어 있습니다.
- 디스플레이: Adafruit 5394는 1 × 11 핀을 납땜해야 하고, 납땜 없는 EYESPI 플렉스 케이블은 50 / 100 / 200 mm(판매처에 따라 250 mm)뿐이라 관절 4개를 지나는 37–41 cm에 못 미칩니다. 그래서 Waveshare 1.9인치 모듈(같은 170 × 320 IPS): 뒷면 황동 스터드 4개에 프레임을 M2 × 3으로 조이고, 프레임을 M11 받침의 기둥 4개에 밀어 끼웁니다.
- 디스플레이 케이블: 동봉 20 cm(필요 15.3 cm, 왼쪽 어깨 클립 옆 이음부까지) + 수-암 점퍼 30 cm 8개(필요 26.1 cm). 핀: VCC 17, GND 20, DIN 19, CLK 23, CS 24, DC 22, RST 18, BL 12.
- 카메라 케이블 길이: Adafruit는 동봉 케이블 길이를 공개하지 않습니다. 제품 사진(USB-A 12 mm · 기판 25 mm로 축척)으로 잰 값은 약 43 cm(40–46). M11에서는 44–52 cm가 필요합니다(관절 전체 범위, CAD 추정) → 먼저 재 보세요. 52 cm 이상이면 그대로, 44–52 cm이면 USB 연장 20 cm를 베이스 2층에 추가, 그보다 짧으면 더 긴 케이블이 필요합니다.
- M11에서 찾은 문제 (출력 부품은 그대로 두고 배선으로 해결): 받침의 카메라 케이블 구멍 뒤 0.35 mm에 P4 앞면이 있어 케이블이 나가지 못합니다 → 카메라 케이블도 왼쪽 디스플레이 창으로 뺍니다. 어깨판 클립 홈은 어깨판 나사 머리로 차 있습니다 → 케이블은 클립 옆에 케이블 타이로 묶습니다.
- CAD 검사: 간섭 없음, 프레임 나사 4/4(1.9 mm 물림), 3,502자세 충돌 0, 최대 토크 0.196 N·m(70 %), 넘어짐 여유 39.7 / 29.2 mm, 1,033 g. 카메라 · 디스플레이 케이블 중심선은 부품과 겹치지 않음(M11은 최대 11.5 mm 관통). 아직 FAIL: 남는 길이를 휘게 그린 케이블이 최대 1.5 mm 겹침 — 실물에서는 묶는 위치로 정리. 실물 조립 · 배선은 아직 안 해 봤습니다.

### M11 (2026-10-28) — 실제로 꽂히는 배선 기준으로 베이스 재설계

- 2XL 케이블: 베이스 모터(P1)를 회전축 기준 90° 돌려(출력축은 그대로라 움직임은 같음) 커넥터를 척추 케이블 구멍 옆으로 옮겼습니다. 그래서 OpenCR → P1 → P2 → P3 → P4를 서보마다 1개씩 들어 있는 X3P 180 mm 4개로 잇습니다(필요 최대 163 mm). M10은 300 mm 리드가 필요했습니다.
- USB (꺾임 부품을 명시): 웹캠은 Pi 뒤쪽 USB에 꽂은 업앵글 USB-A 어댑터 1개(예: Pro Signal PSG91064, 28 × 17 × 34 mm)에 위에서 꽂습니다. OpenCR ↔ Pi는 양끝 90° 케이블 1개(micro-B는 케이블이 위로, USB-A는 케이블이 앞으로, 둘 다 눕혀서). 일자 플러그만 쓰면 베이스가 약 22 mm 넓어집니다(142 mm).
- Raspberry Pi 3 B+: 라즈베리파이 공식 도면(RP-008336-DS-1)의 부품 배치와 40핀 좌표 그대로(높이는 일반값). Pi는 데크 아래에 M2.5 × 20 스탠드오프 4개로 매답니다.
- 꽂기 검사: 베이스 안 플러그 11개를 실제 크기로 그리고, 조립 단계마다 손으로 밀어 넣을 길이 비어 있는지 확인 — 11/11 통과. OpenCR micro-USB는 오른쪽 벽 아래 창으로 꽂습니다.
- CAD 검사(M11): 간섭 없음, 관절 범위 2,633자세 충돌 0, 동작 10개 통과, 최대 토크 0.185 N·m(66 %), 넘어짐 여유 39.7 / 30.1 mm. 베이스 120 × 110 mm(앞으로 7 mm). 실물 배선 · 출력은 검증 전, 플러그 크기는 판매 정보의 일반값입니다.
- 실측이 필요한 것: OpenCR 배터리 커넥터 종류, 웹캠 케이블 길이(약 45 cm 필요)와 USB 플러그 길이(33 mm 이하), 90° 케이블의 꺾임 방향, Pi 단자 높이.

### M10 PLA (2026-10-27) — 지지대를 떼도 부러지지 않게 전부 재검토

- 31조각 중 카메라 받침 1개만 지지대. 나머지는 45° 보강 · 코벨 · 세로 슬롯 · 출력 방향 변경으로 지지대 없이 출력되고, 긴 브리지 세 곳은 함께 출력해 떼어 내는 보조물(부품보다 약한 목)로 받칩니다.
- 떼는 힘 · 층 방향 하중 · 나사 길이를 손계산으로 확인(PLA 층 방향 40 MPa, 층 사이 15 MPa 가정): 가장 약한 곳이 안전율 2.1. M9의 실제 오류(서보 데크 보스 벽 0.15 mm, 레일 받침 인서트 돌출, 귀 · 어깨판 방향, 안테나 막대 길이, 외피 나사 M3 × 12 → × 18 등)도 고쳤습니다. 자세한 건 출력 도면 탭.
- 새 탭 조립 설명서: 레고 설명서처럼 20단계로, 단계마다 넣을 부품 · 나사 개수와 들어가는 방향을 CAD 조립체 그대로 보여 줍니다.
- 3D 모델: 오른쪽 드래그로 위아래 · 좌우 이동, 키보드 방향키로 이동, Shift+방향키로 돌리기.

### M9 PLA (2026-10-26) — 보드를 모터 아래로, 베이스를 작게

- 베이스 137 × 152.5 mm → 120 × 103 mm (책상 면적 41 % 감소). 대신 층이 생겨 높이가 47.5 → 93.5 mm, 모든 관절이 46 mm 올라갔습니다.
- 층 구조: 바닥 OpenCR → 레일 위 Raspberry Pi → 서보 데크 위 베이스 모터(P1) + 배터리 슬레드. 외피는 위에서 씌우고 바닥에서 나사 4개.
- 모든 출력 부품을 흰 PLA로(칠은 나중에), 학교 Cubicon Single Plus(베드 240 × 190 × 200 mm)에서 하나씩 따로 출력 — 22개 파일 · 31개 조각, 모두 베드에 들어감. 자세한 건 출력 도면 탭.
- CAD 검사(M9 기준): 부품끼리 간섭 없음, 소프트 리밋 안 3,502개 자세 충돌 0, 기본 동작 10개 충돌 0, 최대 중력 토크 0.185 N·m(상한 0.28의 66 %), 정적 전도 여유 최소 27.0 mm. 실물 출력 · 조립 · 결선 · 발열은 검증 전입니다.

### 배터리 · 전원 — 3S 1500 mAh LiPo, XT60 (2026-10-27 결정)

전압

3S 11.1 V (완충 12.6 V). 2XL430-W250의 입력 범위는 6.5–12.0 V, 권장 11.1 V이고, ROBOTIS TurtleBot3도 같은 계열(XL430)을 3S로 씁니다. 완충 직후 12.6 V는 표기 상한보다 조금 높으니 첫 충전 뒤 서보 상태를 확인하세요.

배터리 칸

최대 90 × 35 × 30 mm(M11) — 흔한 3S 1500 mAh 팩(71–88 × 33–35 × 22–27 mm, 판매 목록 기준)이 들어갑니다. 왼쪽 벽 문(높이 34 mm)으로 슬레드째 꺼냅니다. 사기 전에 팩 크기를 이 칸과 비교하세요.

XT60

팩의 XT60을 문 쪽 포켓에서 OpenCR 배터리 단자로 가는 피그테일(14 AWG, 약 150 mm로 잘라 슬레드를 빼도 연결이 유지)에 꽂습니다. OpenCR 배터리 커넥터 종류는 보드에서 확인 필요.

방전 한계

셀당 3.5 V(팩 10.5 V) 아래로 쓰지 않도록, OpenCR에서 입력 전압을 읽어 멈추게 하는 것을 권장합니다 (아직 구현 안 함).

어댑터 전원

왼쪽 벽 아래 DC 잭 구멍 = OpenCR 자체 DC 잭이라 12 V 어댑터를 배선 없이 바로 꽂습니다(ROBOTIS SMPS 12 V 5 A 규격, 플러그 크기는 확인). OpenCR 전원 스위치도 바로 옆 슬롯으로 누릅니다. 배터리와 어댑터를 함께 꽂았을 때의 전환 동작은 실물에서 확인하세요.

Pi 전원

OpenCR 5 V 출력(5267-02A, 최대 4 A) → Pi GPIO 2 · 4번(5 V) · 6번(GND) 핀, 직접 만드는 리드(Molex 5264-02 → 1 × 3 듀폰). micro-USB 소켓은 비워 둡니다(Pi 입력 퓨즈를 거치지 않음).

충전

LiPo는 꺼내서 LiPo 안전 백 안에서 3S 밸런스 충전기로 충전하세요. 로봇 안에서 충전하지 않습니다.

### 색 · 출력

- 모든 부품을 흰 PLA로 뽑고 RC3 원래 색으로 칠합니다: 크림(외피 · 머리 · 요크 · 어깨판), 다크 그레이(바닥 · 프레임 · 캡), 올리브(잎 · 귀 · 턴테이블 링), 검정(앞 패널). 얼굴 테와 라이트 띠는 칠하지 않아 빛이 퍼지게 둡니다. 3D 모델은 칠한 뒤 모습입니다.
- 칠하는 순서와 가려야 할 면(인서트 · 끼워맞춤 · 미끄러지는 면)은 출력 도면 탭의 "칠하기"에 있습니다.

### 모델링 기준 부품

디스플레이

Adafruit 1.9" 320 × 170 IPS TFT (ST7789), 제품 5394. 표시 영역 42.72 × 22.70 mm, 보드 57.2 × 36.6 × 5.2 mm, 장착 구멍 52.0 × 31.7 mm. Pi에서 SPI로 구동. 2 mm 스모크 아크릴판 · 0.2 mm 검은 마스크 뒤.

카메라

Adafruit Ultra Tiny USB Camera, 제품 5733. 26 × 8 × 10 mm, Ø 6.5 mm 렌즈 구멍. 카메라 쪽은 1 mm 피치 4핀 커넥터이고 동봉된 변환 케이블 끝이 USB-A(길이는 제품 정보에 없음 — 실측). 작은 커넥터 쪽을 베이스에서 위로 통과시키고, USB-A는 Pi 뒤쪽 USB의 업앵글 어댑터에 위에서 꽂습니다.

제어 · 모터

ROBOTIS OpenCR 1.0 (공식 RevH STEP; micro-USB는 STEP에 없어 핀맵 사진으로 배치) + Raspberry Pi 3 Model B+ (공식 도면 RP-008336-DS-1, 높이는 일반값). DYNAMIXEL 2XL430-W250-T 4개 = 관절 6개 (공식 STEP), 데이지 체인 X3P 180 mm 4개.

이전 모델

RC3(PETG, A–F 묶음 출력)와 캐릭터 스킨, 책벌레(worm_C4 · B7)는 3D 모델 탭에서 비교용으로 남겨 두었습니다.
