NOTIFYII/notifyi-digital-twin/(commit log)

2026-10-21 Publish the Notifyi digital twin viewer (RC3 + character skins)
    Static copy of 06_Viewer: three.js from jsDelivr, motions, and slimmed
    CAD assemblies as base64 JSON chunks. Built by scripts/build_static_viewer.py.
2026-10-21 Add the print-drawing tab and the parts / power note
    print.html shows RC3's six connected print files (A-F) with cut tabs,
    part lists, slicer estimates, cut maps and STL downloads; base parts that
    depend on the battery / power decision are marked. A "기준 부품 · 전원 안내"
    sheet names the display (Adafruit 5394), camera (Adafruit 5733) and
    controllers the model is built around.
    [A_cream_CONNECTED_8parts.stl, B_dark_CONNECTED_12parts.stl, C_olive_CONNECTED_4parts.stl, D_clear_CONNECTED_2parts.stl, E_dark_chassis_1part.stl, F_TPU95A_CONNECTED_3parts.stl]
2026-10-21 Add the research tab (paper drafts and hypotheses)
    research.html: the P1 thesis and abstract, pre-registration hypotheses,
    design, Study 1 stimuli, the Study 0 stimulus check, the power
    simulation, the P2-P4 abstracts and the self-review of all four.
    Drafts with placeholders marked; no human data yet.
2026-10-21 Rebuild the research tab as a bilingual project page
    research.html now follows the layout of recent paper project pages:
    title, links, a live teaser (the twin looping the gradual and abrupt
    P1 cues, switchable between the botanical and technical skins), TL;DR,
    abstract, hypotheses, design, clickable stimuli, preliminary checks,
    follow-up papers, self-review and BibTeX - in Korean and English with a
    language switch. The viewer gains an embed mode (?ui=0&play=1) and the
    two P1 cue motions.
2026-10-21 One top bar on every page; deepen the research page
    All three pages share the same fixed bar: brand left, page tabs exactly
    centred, the language switch on the research page. The viewer's panels
    and the print layout sit below it; embedded demos hide it.
    The research page gains research questions and contributions, a
    two-pathway model (attentional priority vs fit/fluency/liking, with the
    onset bypass), secondary hypotheses H5-H7 and exploratory H8 with their
    tests, a predicted-pattern chart (assumed values, labelled as such), a
    table of rival explanations and how the design rules them out, and a
    positioning table. The survey adds the ATI and plant-affinity items.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
2026-10-26 Add mech_M9_PLA: boards under the base servo, compact base, per-part PLA prints
    The 3D tab opens on mech_M9_PLA (OpenCR and Pi stacked under the base servo,
    base 120 x 103 mm, LiPo sled behind a left-wall door, the OpenCR DC jack and
    switch through the same wall). The print tab now lists every part as its own
    PLA print for the Cubicon Single Plus, turned to its print orientation on the
    240 x 190 mm bed, with settings, slicer estimates, PLA changes and STLs; RC3's
    A-F connected packs are no longer published. Info panel: battery and power
    notes (3S recommended, 4S only with a 12 V step-down).
    [01_base_shell.stl, 02_base_floor.stl, 03_servo_deck.stl, 04_pi_rail.stl, 05_battery_sled.stl, 06_door_latch.stl, 07_base_front_panel.stl, 08_cable_bushing.stl]
2026-10-26 Version the print tab's script URL so browsers fetch the new one
2026-10-26 M9: RC3 colours painted on white PLA, 3S battery bay
    The model is back in RC3's colours (cream, dark grey, olive, black; the face
    ring and light band stay white). Every part is printed in white PLA and
    painted afterwards: the print tab lists the paint colour per part and a
    painting guide (inserts first, mask fits). The battery bay is sized for the
    chosen 3S 1500 mAh pack (up to 90 x 37 x 30 mm, door 34 mm high); the 4S
    step-down space is gone. Info panel updated.
    [01_base_shell.stl, 05_battery_sled.stl, 11_pivot_cap_1p0_frame_dark.stl]
2026-10-27 M10: support-safe PLA print parts, free 3D camera
    mech_M10_PLA is the default model: every printed part re-checked so that
    taking supports off a PLA print cannot break it (30 of 31 pieces print
    without support; print aids with weak necks; removal, layer-load and
    screw-length hand checks). The print tab lists M10's parts with their
    supports, print aids and how to remove them; M9's superseded print
    files are removed. The 3D viewer moves and tilts freely (buttons, keys,
    right-drag), frames the model clear of the panels and can hide them.
    [01_base_shell.stl, 02_base_floor.stl, 03_servo_deck.stl, 04_pi_rail.stl, 05_battery_sled.stl, 06_door_latch.stl, 07_base_front_panel.stl, 08_cable_bushing.stl]
2026-10-27 Print tab: four parts carry print aids (the strap's membranes count)
2026-10-27 Assembly guide tab, recent HRI/CHI work, original 3D view
    - 조립 설명서: a LEGO-book style 20-step guide on mech_M10_PLA's own
    assembly (parts fly in along arrows; parts and screw callouts)
    - research: recent HRI / CHI papers and how the study develops (Korean)
    - 3D tab back to its original layout (camera buttons removed); arrow
    keys still move / turn the model
2026-10-28 M11: base rebuilt for real wire connections
    The base servo is turned 90 deg so the DYNAMIXEL bus runs OpenCR -> P1 -> P2 -> P3 -> P4
    on the four supplied 180 mm X3P cables. The Raspberry Pi 3 B+ comes from the official drawing
    and hangs under the deck on standoffs. Every plug in the base is drawn at its real size, with
    a named up-angle USB adapter and a 90-deg USB cable. The print tab, assembly guide and info
    panel now show M11.
    [01_base_shell.stl, 02_base_floor.stl, 03_servo_deck.stl, 04_battery_sled.stl, 04_pi_rail.stl, 05_battery_sled.stl, 05_door_latch.stl, 06_base_front_panel.stl]
2026-10-29 M12: every part screwed, real display and camera, Cubicon plates
    - 3D tab opens on mech_M12_screws (M11, M10, M9 kept)
    - print tab: M12's 24 files / 30 pieces, nine Cubicon Single Plus plates
    (STL + 3MF) with Cubicreator4 basic settings; .hfb slots marked pending
    - assembly guide re-made for M12: every screw at the step it goes in
    - info panel: soldering answer, maker data, fastening, antenna badges
    - M11's superseded print folder removed
    [01_base_shell.stl, 02_base_floor.stl, 03_servo_deck.stl, 04_battery_sled.stl, 05_door_latch.stl, 06_base_front_panel.stl, 07_cable_bushing.stl, 08_turntable_ring.stl]
2026-10-29 Print tab: Cubicreator4 expert settings for the nine plates
    [P1_base_shell.3mf, P2_base_floor.3mf, P3_servo_deck.3mf, P4_head_face.3mf, P5_camera_cradle.3mf, P6_yokes.3mf, P7_sled_strap.3mf, P8_flat_parts.3mf]
2026-10-29 M13: solderless display, same-shape badges, printable Cubicon .hfb
    - 3D tab opens on mech_M13_solderless: the Waveshare 1.9in LCD from its own
    STEP (plugs in, screwed from behind into its brass studs), HGU and SIRLab on
    the same badge plate, plugs / battery / XT60 / standoffs / screws drawn as
    they look; the Enclosure switch now hides the screws that hold enclosures
    - print tab: M13's 30 pieces and nine .hfb files saved by Cubicreator4
    (3DP-310F, PLA), each checked against its plate's settings
    - assembly guide re-made for M13; info panel M13 section
    - M12's superseded print folder removed
    [01_base_shell.stl, 02_base_floor.stl, 03_servo_deck.stl, 04_battery_sled.stl, 05_door_latch.stl, 06_base_front_panel.stl, 07_cable_bushing.stl, 08_yoke.stl]
2026-10-29 Print tab built round the nine Cubicon .hfb plates; cable routes re-drawn
    - print tab: the nine plates first - each with its .hfb download, the
    settings read back from inside the file, Cubicreator's time / weight and
    the pieces laid out on the bed as in the file (in paint colours); per-part
    STLs folded below
    - M13: webcam and display cables re-routed (dense waypoints) with a second
    cradle opening for the webcam cable; P5 re-sliced (9 / 9 .hfb PASS)
    - revision list always fetched fresh
    [12_camera_cradle.stl, P1_base_shell.3mf, P2_base_floor.3mf, P3_servo_deck.3mf, P4_head_face.3mf, P5_camera_cradle.3mf, P5_camera_cradle.stl, P6_yokes.3mf]
2026-10-30 Main page and assembly guide back to M11 (mech_M11_face): M11 parts as printed + solderless face
    - 3D tab opens on mech_M11_face: Waveshare 1.9in LCD in one new printed display frame on the M11
    cradle's standoffs, supplied 20 cm cable + 30 cm jumpers, camera cable out of the cradle's left opening
    - Assembly guide: M11 steps, cables plugged in the base first, display frame step, face box last
    - Print tab: box for the new part (.hfb, STL, 3MF, STEP) and all M11 STLs; the 9 plates stay M13's
    - Info panel: real cable lengths (camera not published, ~43 cm from photo; M11 needs 44-52 cm)
    [F1_display_frame.3mf, F1_display_frame.stl, display_frame.step]
2026-10-30 Remove M12 and M13 from the site; print tab on M11
    - 3D tab lists mech_M11_face (default) and mech_M11_wiring; M12 / M13 models and print files removed
    - Print tab: M11's nine Cubicon plates (M11 parts + the new display frame on P9), each sliced in
    Cubicreator4 to .hfb (9/9 checked; about 39.3 h, 385 g PLA), per-plate pieces, M11 part notes
    - Info panel: M12 / M13 sections removed
    [01_base_shell.stl, 02_base_floor.stl, 03_servo_deck.stl, 04_battery_sled.stl, 05_door_latch.stl, 06_base_front_panel.stl, 07_cable_bushing.stl, 08_turntable_ring.stl]
2026-11-02 M11b: servo deck passes the shell's bosses, screw holes sized for the screws
    - P3 servo deck: five edge notches past the shell's four floor-screw bosses and its latch boss
    - Holes that bite: M3 pilot d 2.7, M2 pilot d 1.7, no heat-set inserts
    - Print tab: plates P1-P4 re-sliced in Cubicreator4 (9/9 .hfb checked), guide and info panel updated
    [01_base_shell.stl, 02_base_floor.stl, 03_servo_deck.stl, 04_battery_sled.stl, 05_door_latch.stl, 06_base_front_panel.stl, 07_cable_bushing.stl, 08_turntable_ring.stl]
2026-11-02 M11c: shell in two halves that close last; every screw hole reviewed
    - Base shell splits front / rear and closes round the finished, wired robot; six screws to open
    - 62 screws traced through their holes against the vendor STEP; shoulder plate moved onto P3's real hole
    - Guide reordered (26 steps): P4 on its yoke and P1 before the Pi on the bench, wiring and test before the shell
    - No support inside small horizontal holes, no membranes; 5 V lead hole opens to the deck's edge
    - Print tab: 10 plates, new .hfb for the changed plates (10/10 checked)
    [01_base_shell.stl, 01_base_shell_front.stl, 01_base_shell_rear.stl, 02_base_floor.stl, 03_servo_deck.stl, 04_battery_sled.stl, 05_door_latch.stl, 06_base_front_panel.stl]
2026-11-02 M11c: deck screws are button heads (socket heads hit the battery sled); all 72 screws checked
2026-11-02 M11d: every screw and cable drawn where it really goes
    The guide gets the boards' USB and the bus to P1 as steps of their own, plug labels, a from-to table per step and an x-ray button; 81 screws as they look at the step they go in; the display harness as its two real cables with the joint between them; the camera cable from its real plug; battery drawn as LB-012; screw sizes on sale in Korea. Printed parts unchanged from M11c.
    [01_base_shell_front.stl, 01_base_shell_rear.stl, 02_base_floor.stl, 03_servo_deck.stl, 04_battery_sled.stl, 05_door_latch.stl, 06_base_front_panel.stl, 07_cable_bushing.stl]
2026-11-10 Research tab: direction v2, the robot asks with a glance first
    The research tab is now rendered from the Korean direction document: a review of
    prior work, the chosen direction (probe-contingent intervention), hypotheses with
    rejection rules, the 2 x 2 micro-randomised Study 1, and what is implemented so far.
    It shows the capstone poster, a decision-model calculator and a context player that
    drives the embedded twin. Eight ctx_ motions on the real joints of the current build
    (limits, speed, collisions checked in CAD; not run on hardware). The P1 draft page
    moves to research_p1.html. 3D, print and assembly tabs are unchanged.
